ekremturanfirat/Alpina_MainFCC/README.md

# Alpina_MainFCC
Rocket Flight Control Computer 14/02/2025
---
This project is designed based on the specifications of TEKNOFEST 2025 Rocket Competitions A2(Medium Altitude). Please review the license terms of use via the license.txt document.

---
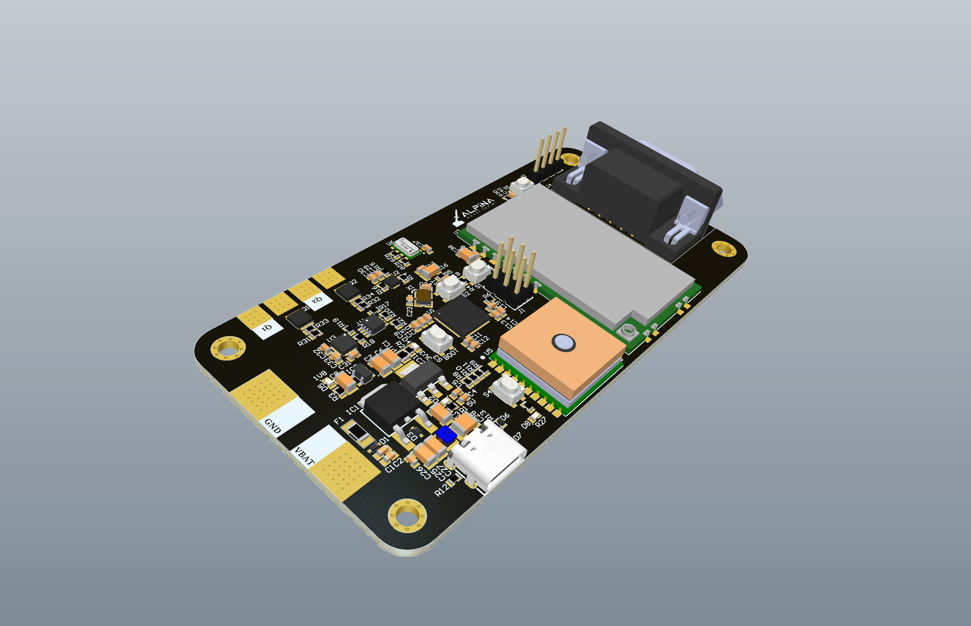
[picture p1: Board/MainFCC_PCBBoardPerspektif.png]


---
## Avionic Design Team Members
I would like to thank _Ayçin Erbil, Ayşe Hazal Demirci, Büşra Yılmaz, Fatmanur Özen and Meryem Şen_, the avionics design members whose leadership I took on in the design of the board throughout the project.

---
### Altium Designer Files
You can download the Altium Designer files of the project from [here](https://github.com/ekremturanfirat/Alpina_MainFCC/tree/main/Altium%20Files).

---
### Schematic Files
You can download the Schematic files of the project from [here](https://github.com/ekremturanfirat/Alpina_MainFCC/tree/main/Schematic).

---
### Board Files
You can download the Board files of the project from [here](https://github.com/ekremturanfirat/Alpina_MainFCC/tree/main/Board).

---
### BOM Files
You can donwload BOM(Bill of Materials) files of the project from [here](https://github.com/ekremturanfirat/Alpina_MainFCC/tree/main/BOM).
