ekremturanfirat/Alpina_MainFCC/Board/MainFCC_PCBBoard.png

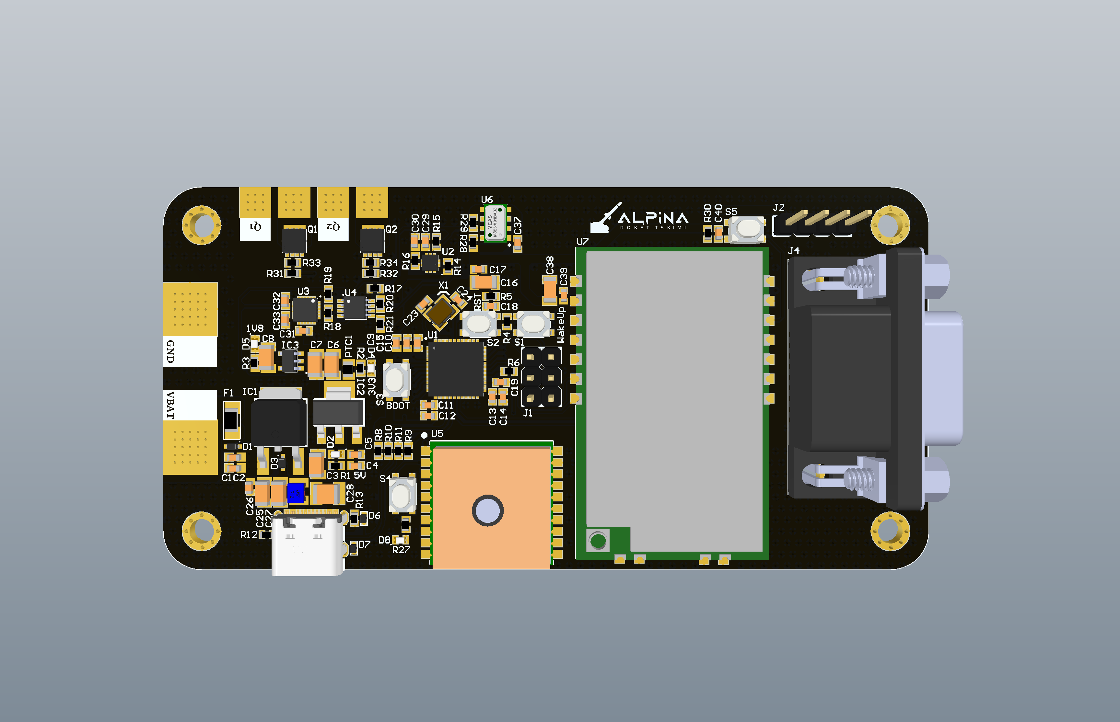
Board/MainFCC_PCBBoard.png
