ekremturanfirat/Alpina_MainFCC/Board/MainFCC_PCBBoardBottom.png

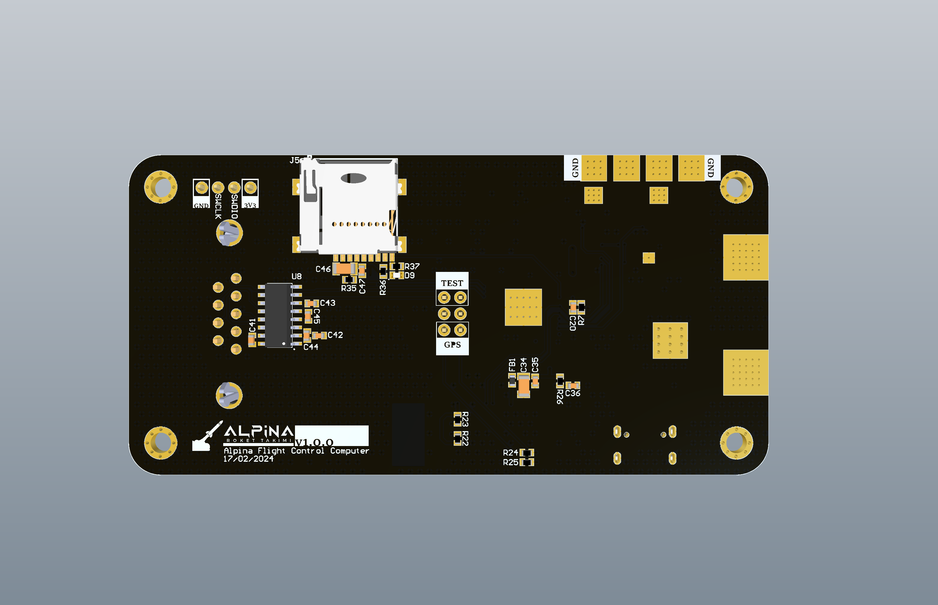
Board/MainFCC_PCBBoardBottom.png
