ekremturanfirat/Alpina_MainFCC/BOM/BOM.pdf

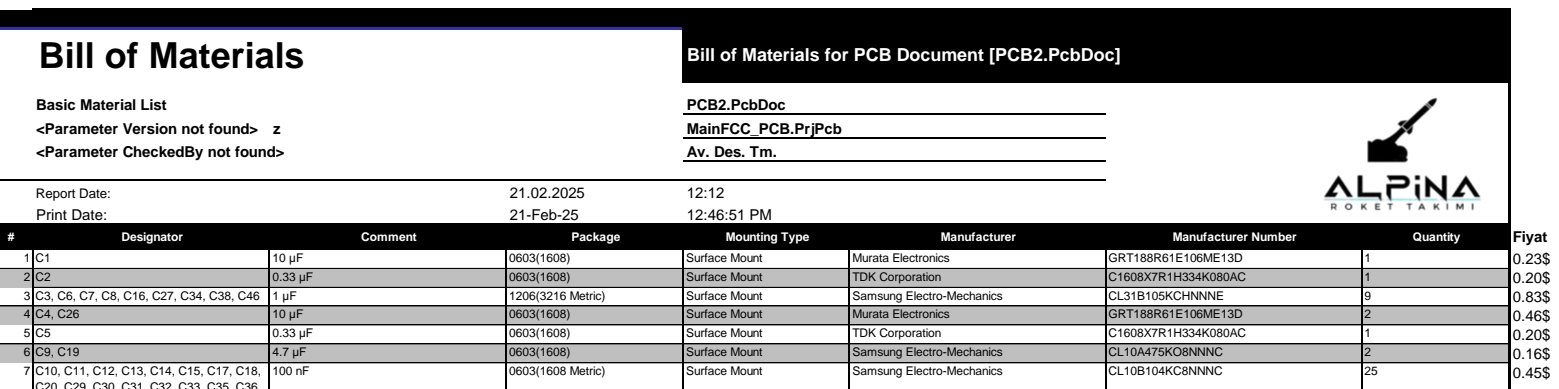
[picture p4: figure]
Basic Material List; PCB2.PcbDoc; Report Date:; Print Date:; 21-Feb-25; Designator; Comment; Package; Mounting Type; Manufacturer; Manufacturer Number; Quantity; Fiyat; Surface Mount; Murata Electronics; GRT188R61E106ME13D; TDK Corporation; Samsung Electro-Mechanics; CL10A475KO8NNNC; 0603(1608 Metric); CL10B104KC8NNNC

Bill of Materials | Bill of Materials for PCB Document [PCB2.PcbDoc]
<Parameter Version not found> z | MainFCC_PCB.PrjPcb
<Parameter CheckedBy not found> | Av. Des. Tm.
3 | C3, C6, C7, C8, C16, C27, C34, C38, C46 | 1 µF | 1206(3216 Metric) | Surface Mount | Samsung Electro-Mechanics | CL31B105KCHNNNE | 9 | 0.83$

C10, C11, C12, C13, C14, C15, C17, C18, C20, C29, C30, C31, C32, C33, C35, C36, C37, C39, C40, C41, C42, C43, C44, C45, C47

8 | C23, C24 | 18 pF | 0603(1608) | Surface Mount | YAGEO | CC0603JRNPO9BN180 | 2 | 0.20$
9 | C25 | 47 µF | 1206(3216) | Surface Mount | TDK Corporation | C3216X5R1E476M160AC | 1 | 0.91$
10 | C28 | 100 µF | 1210(3225 Metric) | Surface Mount | Samsung Electro-Mechanics | CL32A107MPVNNNE | 1 | 1.13$
11 | D1, D3 | B0520LW-7-F | SOD-123 | Surface Mount | Diodes Incorporated | B0520LW-7-F | 2 | 0.36$
12 | D2, D4, D5 | Red | 0603(1608) | Surface Mount | Würth Elektronik | 150060RS75000 | 3 | 0.42$
13 | D6, D7 | DESD3V3S1BL-7B | 0402 (1006 Metric) | Surface Mount | Diodes Incorporated | DESD3V3S1BL-7B | 2 | 0.34$
14 | D8 | Green | 0603(1608) | Surface Mount | Würth Elektronik | 150060GS75000 | 1 | 0.14
15 | D9 | White | 0603(1608) | Surface Mount | Harvatek Corporation | B1931TW--20P000314U1930 | 1 | 0.10$
16 | F1 | C1Q 5 | 1206(3216) | Surface Mount | Bel Fuse Inc. | C1Q 5 | 1 | 0.37$
17 | FB1 | BLM18BD601SN1D | 0603(1608 Metric) | Surface Mount | Murata Electronics | BLM18BD601SN1D | 1 | 0.10$
18 | IC1 | 7805 | DPAK | Surface Mount | onsemi | MC7805BDTG | 1
19 | IC2 | NCP1117 - 3v3 | SOT-223 | Surface Mount | onsemi | NCP1117ST33T3G | 1 | 1.17$
20 | IC3 | MIC5504-1.8YM5-TR | SOT-23-5 | Surface Mount | Microchip Technology | MIC5504-1.8YM5-TR | 1 | 0.16$

21

J1 | 2x3 | | 1
22 | J2 | 1x4 | | 1
23 | J3 | USB4105 | USB4105 | THT - SMD R/A | GCT | USB4105-GF-A | 1 | 0.78$
24 | J4 | Female D-Sub | | THT | Assmann WSW Components | A-DF 09 A/KG-T2S | 1 | 0.83$
25 | J5 | MEM2075 | MEM2075 | Surface Mount | GCT | MEM2075-00-140-01-A | 1 | 1.86$
26 | L1 | 2.2 µH | 1008 (2520 Metric) | Surface Mount | Samsung Electro-Mechanics | CIGT252008LM2R2MNE | 1 | 0.18$
27 | PTC1 | 0ZCK0020FF2G | 0805(2012) | Surface Mount | Bel Fuse Inc. | 0ZCK0020FF2G | 1 | 0.23$
28 | Q1, Q2 | DMN1004UFV-7 | 8-PowerVDFN | Surface Mount | onsemi | DMN1004UFV-7 | 2 | 1.66$
29 | R1, R2, R3, R4, R37 | 330 | 0603(1608) | Surface Mount | Stackpole Electronics Inc | RMCF0603JT330R | 5 | 0.19$
30 | R5 | 40K | 0603(1608) | Surface Mount | YAGEO | RT0603BRD0740KL | 1 | 0.15$

31

R6, R7, R16, R18, R19, R20, R21, R22, R23, R26, R28, R29, R30, R33, R34, R35, R36

10K | 0603(1608) | Surface Mount | Stackpole Electronics Inc | RMCF0603JT10K0 | 17 | 0.32$
32 | R8, R9 | 1.8K | 0603(1608) | Surface Mount | Stackpole Electronics Inc | RMCF0603JT1K80 | 2 | 0.19$
33 | R10, R11 | 22 | 0603(1608) | Surface Mount | TE Connectivity Passive Product | CRGCQ0603J22R | 2 | 0.20$
34 | R12, R13 | 5.1K | 0603(1608) | Surface Mount | Stackpole Electronics Inc | RMCF0603JT5K10 | 2 | 0.19$
35 | R14, R15 | 4.7K | 0603(1608) | Surface Mount | Stackpole Electronics Inc | RMCF0603FT4K70 | 2 | 0.20$
36 | R17 | 200K | 0603(1608) | Surface Mount | Stackpole Electronics Inc | RMCF0603FT200K | 1 | 0.20$
37 | R24, R25, R27 | 470 | 0603(1608) | Surface Mount | Stackpole Electronics Inc | RMCF0603JT470R | 3 | 0.19$
38 | R31, R32 | 1K | 0603(1608) | Surface Mount | Stackpole Electronics Inc | RMCF0603JT1K00 | 2 | 0.19$
39 | S1, S2, S3, S4, S5 | PTS815-SJM | PTS815 | Surface Mount | C&K | PTS815 SJM 250 SMTR LFS | 5 | 1$
40 | U1 | STM32F411CEU6 | UFQFPN-48 | Surface Mount | STMicroelectronics | STM32F411CEU6 | 1 | 5.37$
41 | U2 | BMP390 | 10-WFLGA | Surface Mount | Bosch Sensortec | BMP390 | 1 | 3.15$
42 | U3 | ICM-20948 | 24-QFN | Surface Mount | TDK InvenSense | ICM-20948 | 1 | 7.11$
43 | U4 | PCA9306DCTR | SSOP-8 | Surface Mount | Texas Instruments | PCA9306DCTR | 1 | 0.55$
44 | U5 | CD-PA1616S | CD-PA1616S | Surface Mount | Adafruit | 790 | 1 | 25$
45 | U6 | MS561101BA03-50 | MS561101BA03-50 | Surface Mount | TE Connectivity Measurement Specialties | MS561101BA03-50 | 1 | 9.30$
46 | U7 | Ebyte-E32-868T30s | | | Ebyte | E32-868T30s | 1 | 15.21$
47 | U8 | MAX3232ESE+ | SOIC-16 | Surface Mount | Analog Devices Inc./Maxim Integrated | MAX3232ESE+ | 1 | 10.46$
48 | X1 | 26 MHz | 4-SMD | Surface Mount | TXC CORPORATION | 7M-26.000MAAJ-T | 1 | 0.89$
Approved | Notes | 119 | 93.53$
Altium Limited Confidential | 21.02.2025 | Page 1
