ekremturanfirat/Alpina_MainFCC/BOM/MainFCC_PCB.xlsx

 | Bill of Materials |  |  | Bill of Materials for Project [MainFCC_PCB.PrjPcb]
 | Basic Material List |  |  | MainFCC_PCB.PrjPcb
 | v1.0.0 |  |  | MainFCC_PCB.PrjPcb
 |  |  |  | Av. Des. Tm.
 | Report Date: |  | 9.02.2025 | 15:32
 | Print Date: |  | 2025-02-09 | 15:37:10
# | Designator | Comment | Package | Mounting Type | Manufacturer | Manufacturer Number | Quantity
1 | C1 | 10 µF | 0603(1608) | Surface Mount | Murata Electronics | GRT188R61E106ME13D | 1
2 | C2 | 0.33 µF | 0603(1608) | Surface Mount | TDK Corporation | C1608X7R1H334K080AC | 1
3 | C3 | 1 µF | 1206(3216 Metric) | Surface Mount | Samsung Electro-Mechanics | CL31B105KCHNNNE | 1
4 | C4, C26 | 10 µF | 0603(1608) | Surface Mount | Murata Electronics | GRT188R61E106ME13D | 2
5 | C5 | 0.33 µF | 0603(1608) | Surface Mount | TDK Corporation | C1608X7R1H334K080AC | 1
6 | C6, C7, C8, C16, C27, C34, C38, C46 | 1 µF | 1206(3216 Metric) | Surface Mount | Samsung Electro-Mechanics | CL31B105KCHNNNE | 8
7 | C9, C19 | 4.7 µF | 0603(1608) | Surface Mount | Samsung Electro-Mechanics | CL10A475KO8NNNC | 2
8 | C10, C11, C12, C13, C14, C15, C17, C18, C20, C29, C30, C31, C32, C33, C35, C36, C37, C39, C40, C41, C42, C43, C44, C45, C47 | 100 nF | 0603(1608 Metric) | Surface Mount | Samsung Electro-Mechanics | CL10B104KC8NNNC | 25
9 | C21, C22 | 5 pF | 0603(1608) | Surface Mount | Samsung Electro-Mechanics | CL10C050CB81PNC | 2
10 | C23, C24 | 18 pF | 0603(1608) | Surface Mount | YAGEO | CC0603JRNPO9BN180 | 2
11 | C25 | 47 µF | 1206(3216) | Surface Mount | TDK Corporation | C3216X5R1E476M160AC | 1
12 | C28 | 100 µF | 1210(3225 Metric) | Surface Mount | Samsung Electro-Mechanics | CL32A107MPVNNNE | 1
13 | D1, D3 | B0520LW-7-F | SOD-123 | Surface Mount | Diodes Incorporated | B0520LW-7-F | 2
14 | D2, D4, D5 | Red | 0603(1608) | Surface Mount | Würth Elektronik | 150060RS75000 | 3
15 | D6, D7 | DESD3V3S1BL-7B | 0402 (1006 Metric) | Surface Mount | Diodes Incorporated | DESD3V3S1BL-7B | 2
16 | D8 | Green | 0603(1608) | Surface Mount | Würth Elektronik | 150060GS75000 | 1
17 | D9 | White | 0603(1608) | Surface Mount | Harvatek Corporation | B1931TW--20P000314U1930 | 1
18 | F1 | C1Q 5 | 1206(3216) | Surface Mount | Bel Fuse Inc. | C1Q 5 | 1
19 | FB1 | BLM18BD601SN1D | 0603(1608 Metric) | Surface Mount | Murata Electronics | BLM18BD601SN1D | 1
20 | IC1 | 7805 | DPAK | Surface Mount | onsemi | MC7805BDTG | 1
21 | IC2 | NCP1117 - 3v3 | SOT-223 | Surface Mount | onsemi | NCP1117ST33T3G | 1
22 | IC3 | MIC5504-1.8YM5-TR | SOT-23-5 | Surface Mount | Microchip Technology | MIC5504-1.8YM5-TR | 1
23 | J1 | 2x3 |  |  |  |  | 1
24 | J2 | 1x4 |  |  |  |  | 1
25 | J3 | USB4105 | USB4105 | THT - SMD R/A | GCT | USB4105-GF-A | 1
26 | J4 | Female D-Sub |  | THT | Assmann WSW Components | A-DF 09 A/KG-T2S | 1
27 | J5 | MEM2075 | MEM2075 | Surface Mount | GCT | MEM2075-00-140-01-A | 1
28 | L1 | 2.2 µH | 1008 (2520 Metric) | Surface Mount | Samsung Electro-Mechanics | CIGT252008LM2R2MNE | 1
29 | PTC1 | 0ZCK0020FF2G | 0805(2012) | Surface Mount | Bel Fuse Inc. | 0ZCK0020FF2G | 1
30 | Q1, Q2 | DMN1004UFV-7 | 8-PowerVDFN | Surface Mount | onsemi | DMN1004UFV-7 | 2
31 | R1, R2, R3, R4, R37 | 330 | 0603(1608) | Surface Mount | Stackpole Electronics Inc | RMCF0603JT330R | 5
32 | R5 | 40K | 0603(1608) | Surface Mount | YAGEO | RT0603BRD0740KL | 1
33 | R6, R7, R16, R18, R19, R20, R21, R22, R23, R26, R28, R29, R30, R33, R34, R35, R36 | 10K | 0603(1608) | Surface Mount | Stackpole Electronics Inc | RMCF0603JT10K0 | 17
34 | R8, R9 | 1.8K | 0603(1608) | Surface Mount | Stackpole Electronics Inc | RMCF0603JT1K80 | 2
35 | R10, R11 | 22 | 0603(1608) | Surface Mount | TE Connectivity Passive Product | CRGCQ0603J22R | 2
36 | R12, R13 | 5.1K | 0603(1608) | Surface Mount | Stackpole Electronics Inc | RMCF0603JT5K10 | 2
37 | R14, R15 | 4.7K | 0603(1608) | Surface Mount | Stackpole Electronics Inc | RMCF0603FT4K70 | 2
38 | R17 | 200K | 0603(1608) | Surface Mount | Stackpole Electronics Inc | RMCF0603FT200K | 1
39 | R24, R25, R27 | 470 | 0603(1608) | Surface Mount | Stackpole Electronics Inc | RMCF0603JT470R | 3
40 | R31, R32 | 1K | 0603(1608) | Surface Mount | Stackpole Electronics Inc | RMCF0603JT1K00 | 2
41 | S1, S2, S3, S4, S5 | PTS815-SJM | PTS815 | Surface Mount | C&K | PTS815 SJM 250 SMTR LFS | 5
42 | U1 | STM32F411CEU6 | UFQFPN-48 | Surface Mount | STMicroelectronics | STM32F411CEU6 | 1
43 | U2 | BMP390 | 10-WFLGA | Surface Mount | Bosch Sensortec | BMP390 | 1
44 | U3 | ICM-20948 | 24-QFN | Surface Mount | TDK InvenSense | ICM-20948 | 1
45 | U4 | PCA9306DCTR | SSOP-8 | Surface Mount | Texas Instruments | PCA9306DCTR | 1
46 | U5 | CD-PA1616S | CD-PA1616S | Surface Mount | Adafruit | 790 | 1
47 | U6 | MS561101BA03-50 | MS561101BA03-50 | Surface Mount | TE Connectivity Measurement Specialties | MS561101BA03-50 | 1
48 | U7 | Ebyte-E32-868T30s |  |  | Ebyte | E32-868T30s | 1
49 | U8 | MAX3232ESE+ | SOIC-16 | Surface Mount | Analog Devices Inc./Maxim Integrated | MAX3232ESE+ | 1
50 | X1 | 32.768 kHz | 2-SMD | Surface Mount | ECS Inc. | ECS-.327-5-16-TR | 1
51 | X2 | 26 MHz | 4-SMD | Surface Mount | TXC CORPORATION | 7M-26.000MAAJ-T | 1
Approved |  |  |  | Notes |  |  | 122
