ekremturanfirat/Alpina_MainFCC/Schematic/MainFCC_PCB.pdf

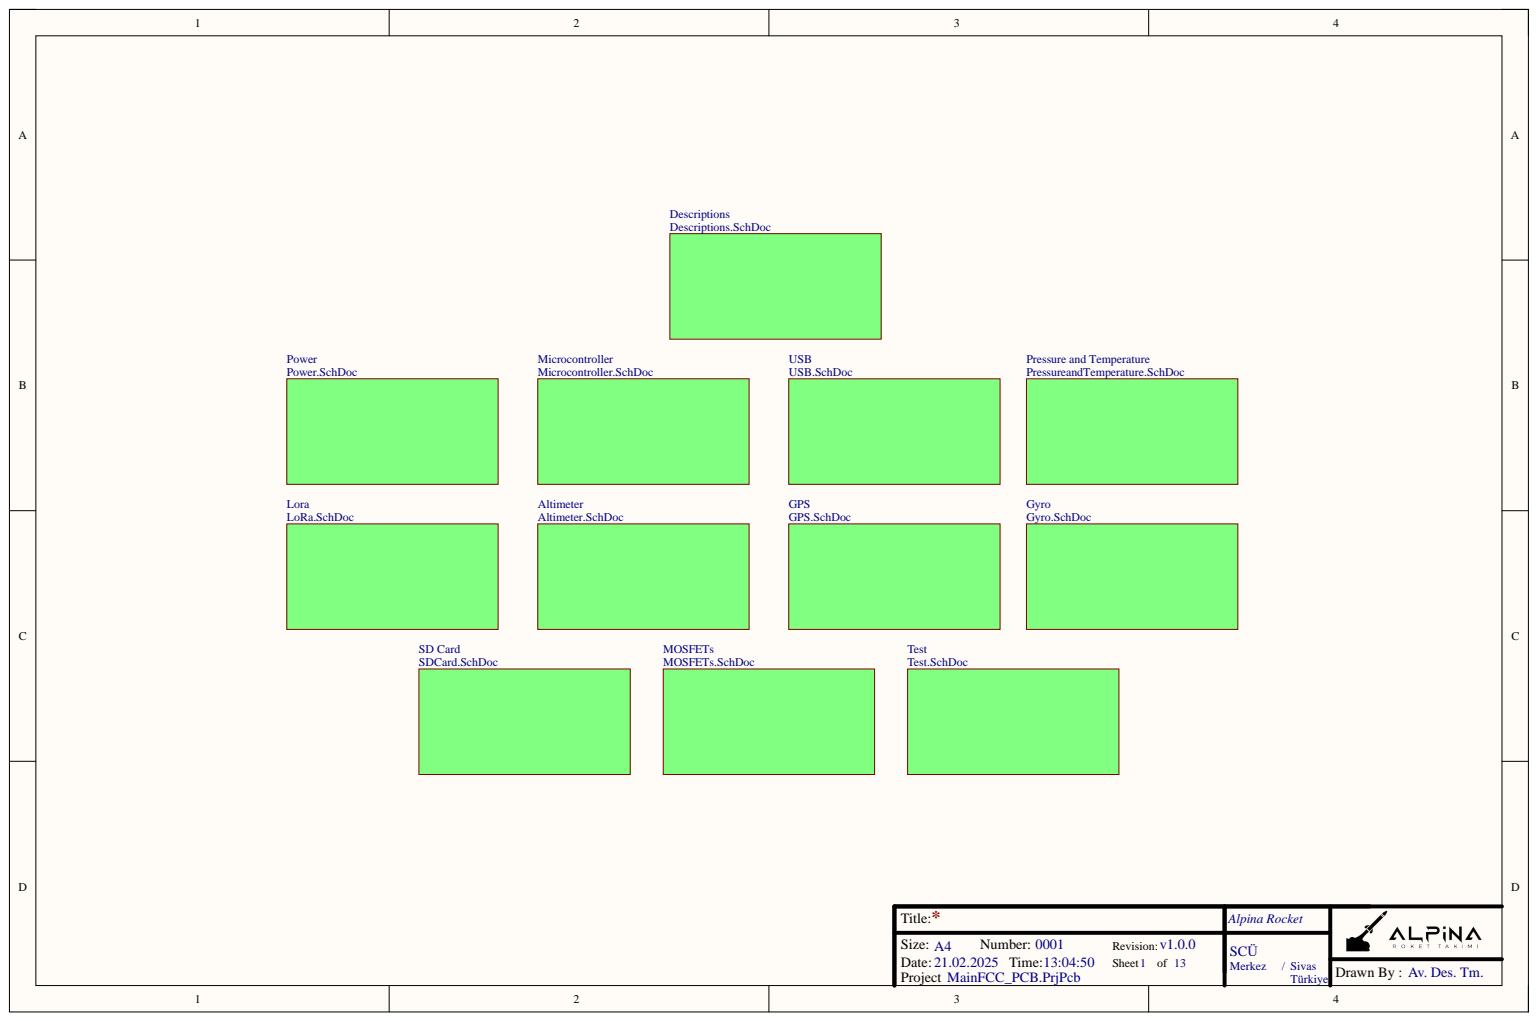
[picture p5: page 1]

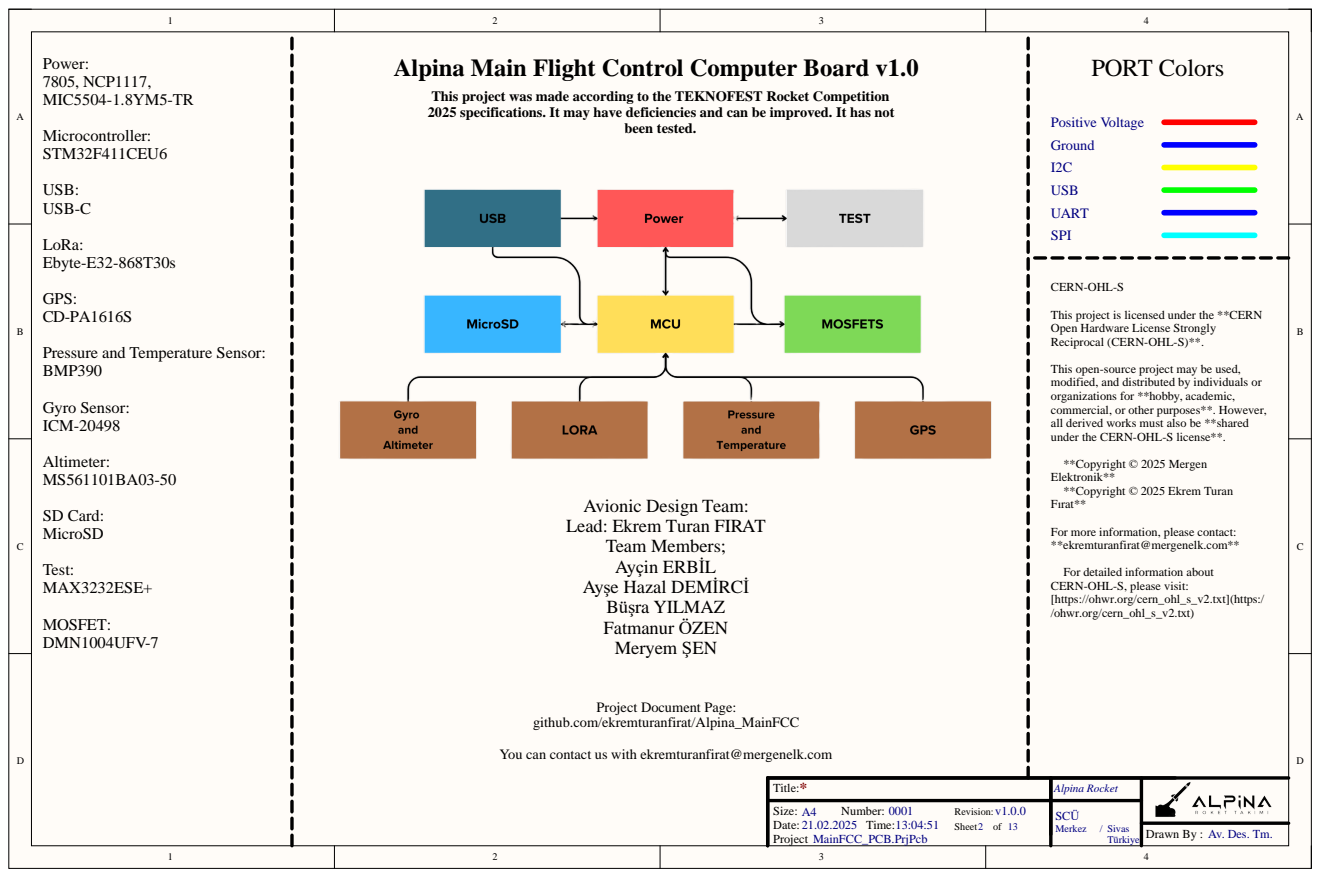
[picture p6: page 2]

Alpina Main Flight Control Computer Board v1.0

This project was made according to the TEKNOFEST Rocket Competition
2025 specifications. It may have deficiencies and can be improved. It has not

This project is licensed under the **CERN
Open Hardware License Strongly
Reciprocal (CERN-OHL-S)**.

This open-source project may be used,
modified, and distributed by individuals or
organizations for **hobby, academic,
commercial, or other purposes**. However,
all derived works must also be **shared
under the CERN-OHL-S license**.

Avionic Design Team:
Lead: Ekrem Turan FIRAT
Team Members;
Ayçin ERBİL
Ayşe Hazal DEMİRCİ
Büşra YILMAZ
Fatmanur ÖZEN
Meryem ŞEN

For more information, please contact:
**ekremturanfirat@mergenelk.com**

For detailed information about
CERN-OHL-S, please visit:
[https://ohwr.org/cern_ohl_s_v2.txt](https:/
/ohwr.org/cern_ohl_s_v2.txt)

You can contact us with ekremturanfirat@mergenelk.com

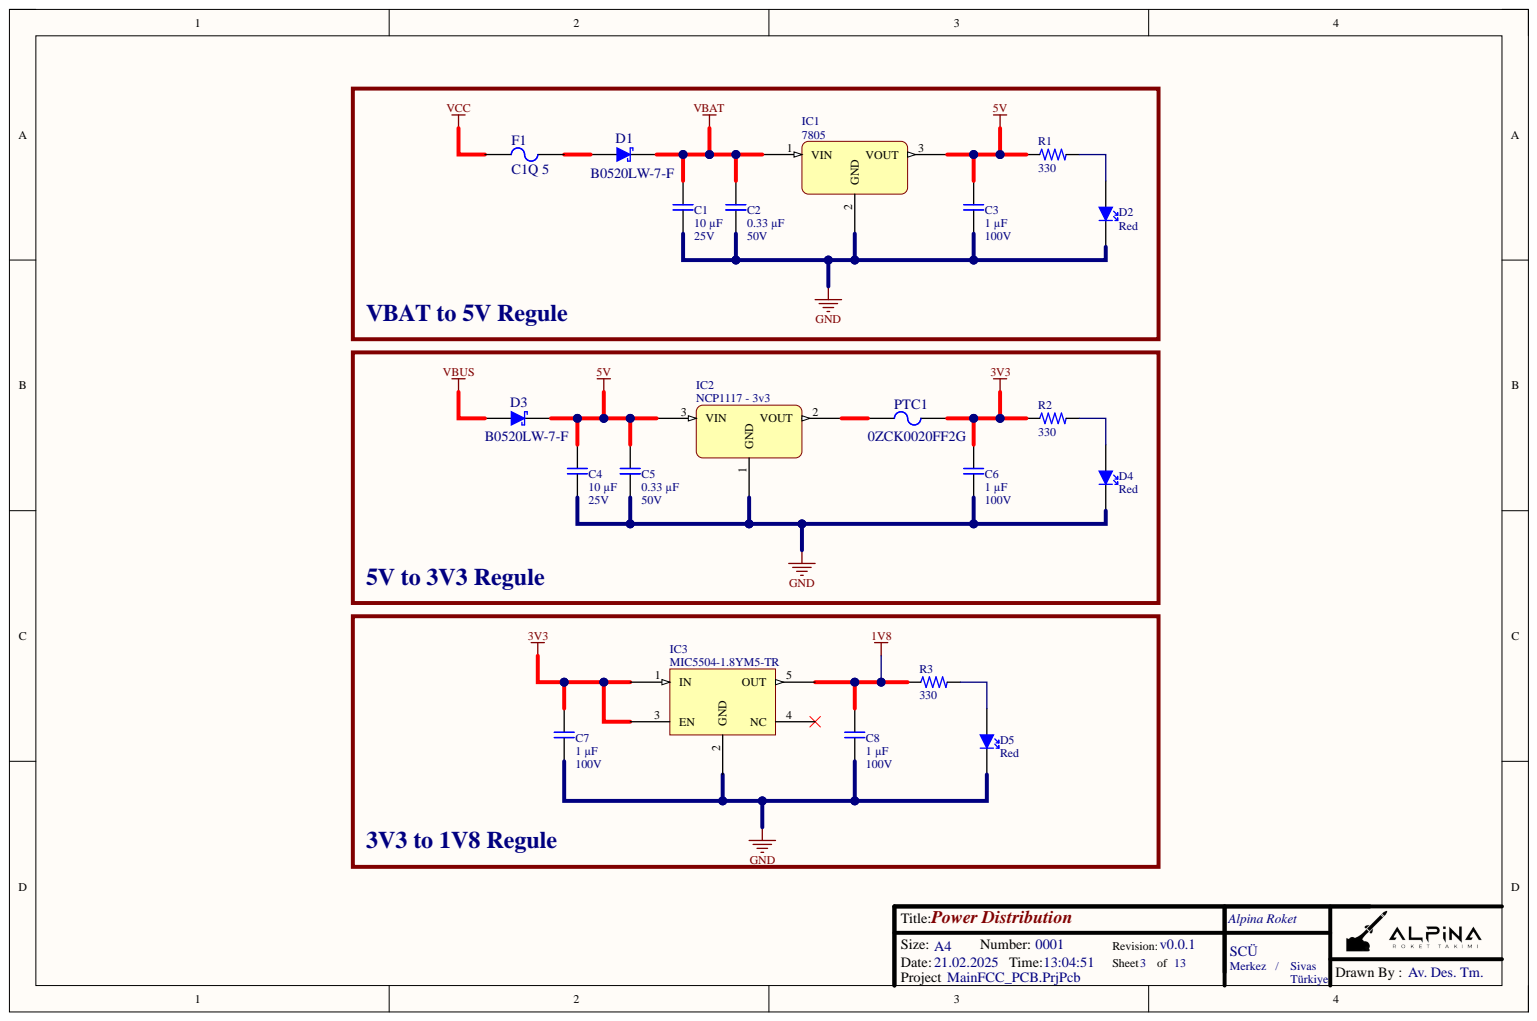
[picture p7: page 3]

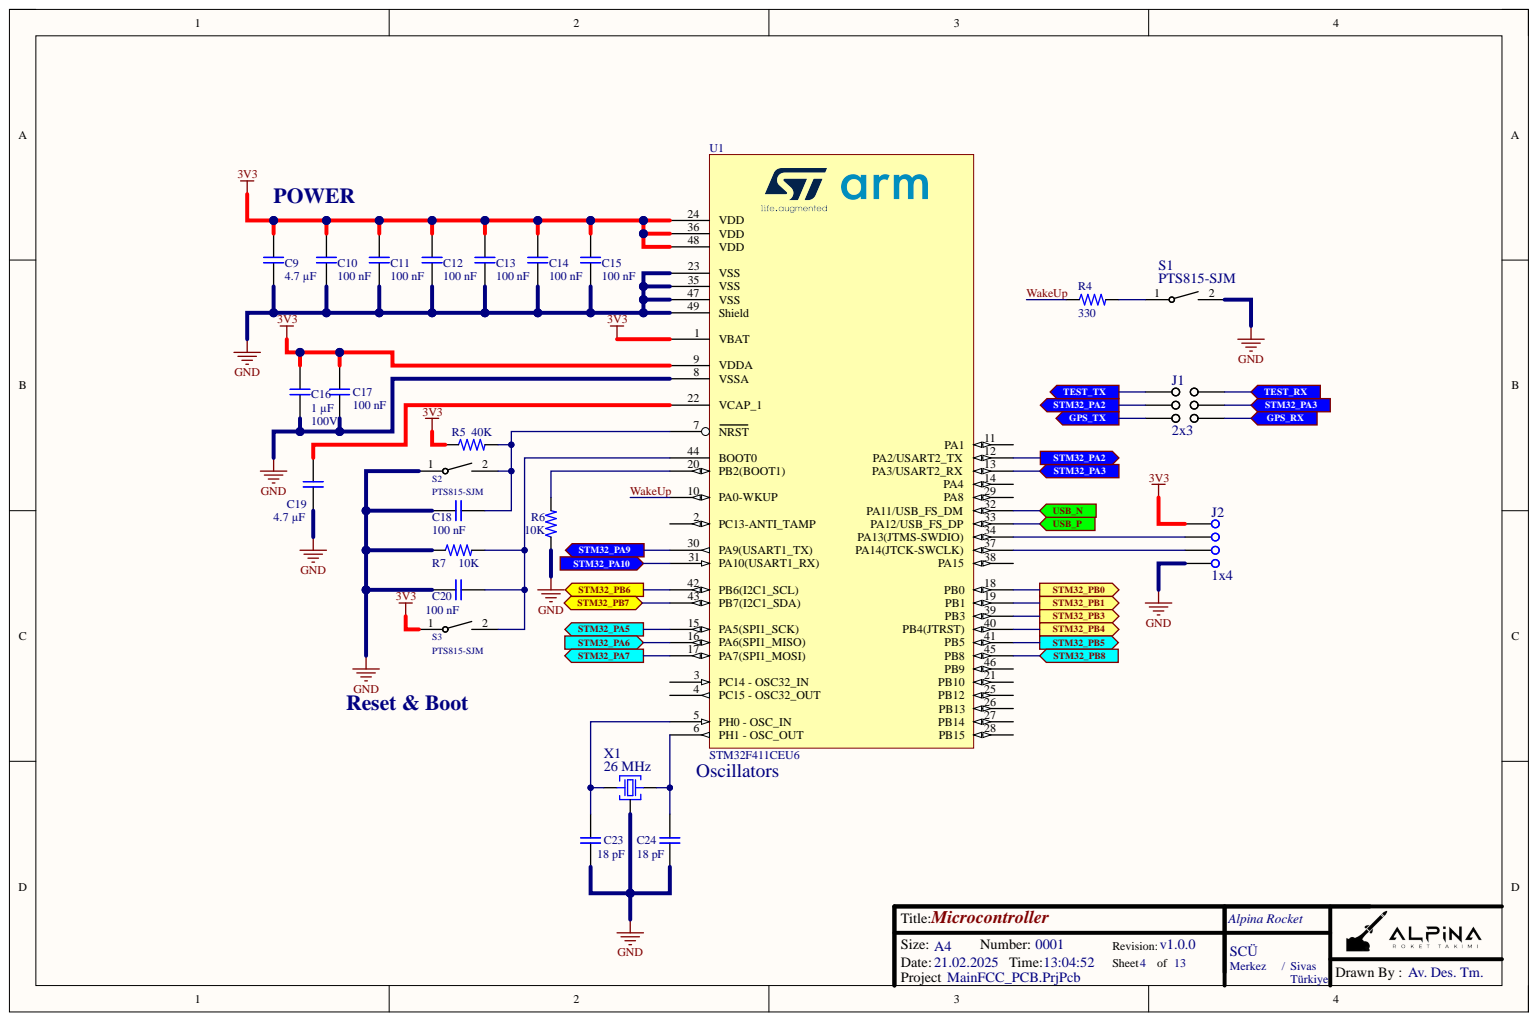
[picture p8: page 4]

VSS 47

3V3 | VBAT 1

1 µF 100V | 3V3 | | NRST 7

BOOT0 44
PB2(BOOT1) 20 PA0-WKUP 10

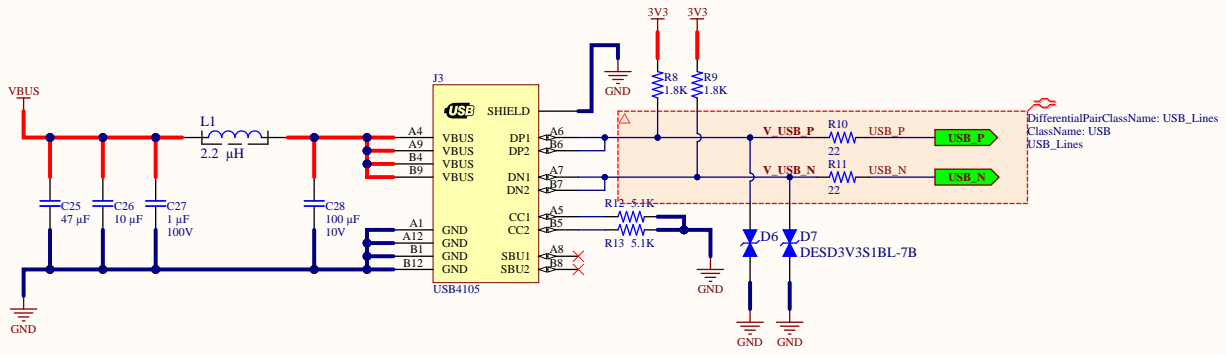
[picture p9: page 5]

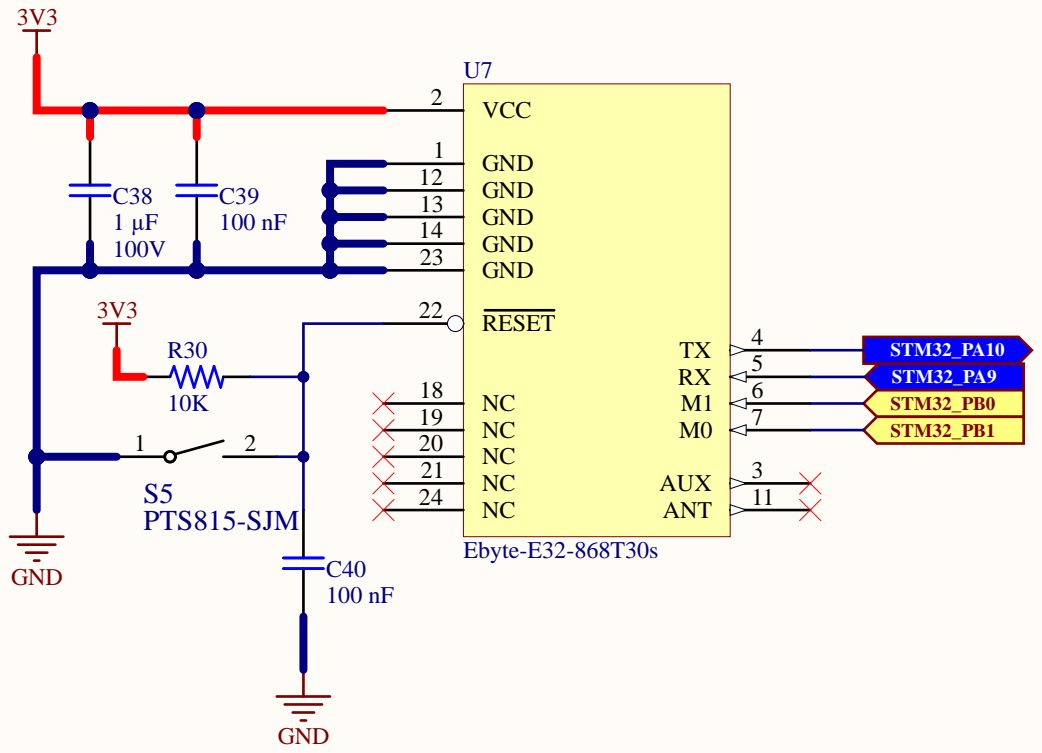
[picture p10: page 6]

100V | | | GND 23

3V3 | RESET 22

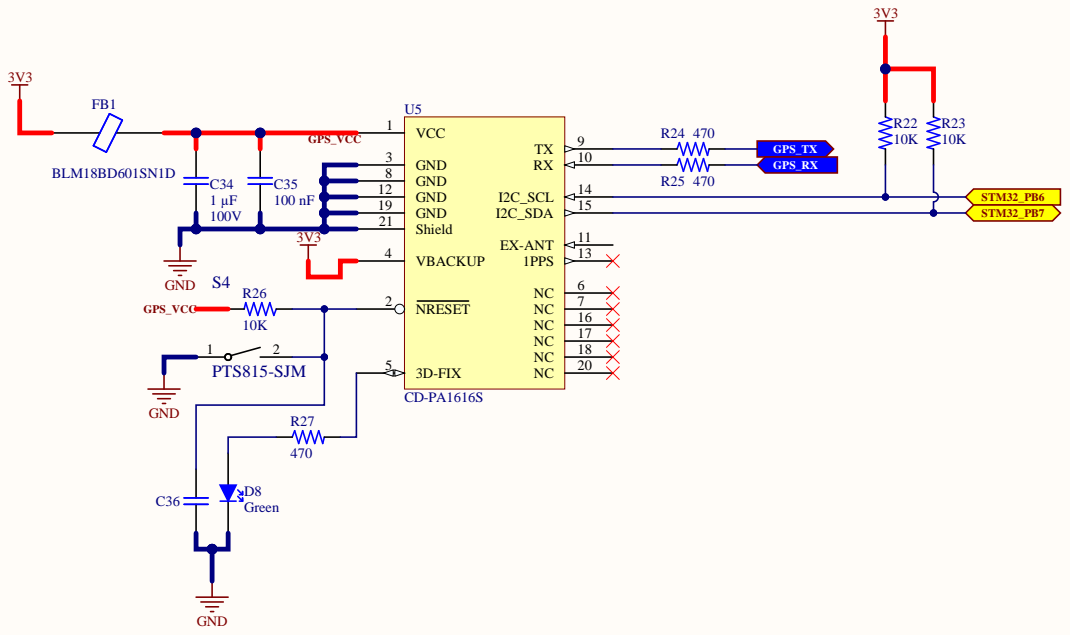
[picture p11: page 7]

100V | | Shield 21

VBACKUP 4

3D-FIX 5

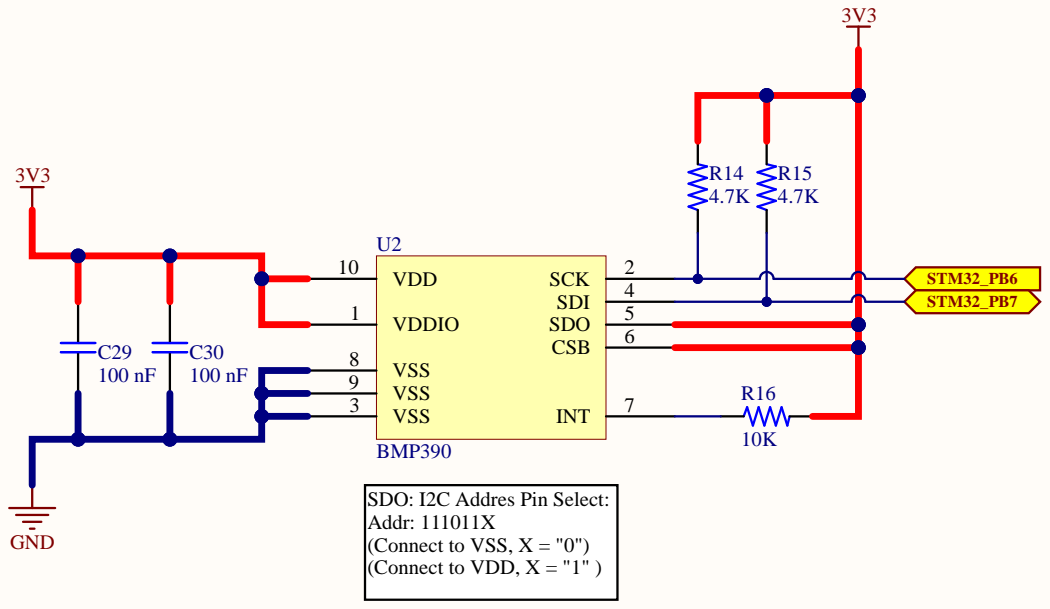
[picture p12: page 8]

SDO: I2C Addres Pin Select:
Addr: 1
(Connect to VSS, X = "0")
(Connect to VDD, X = "1" )

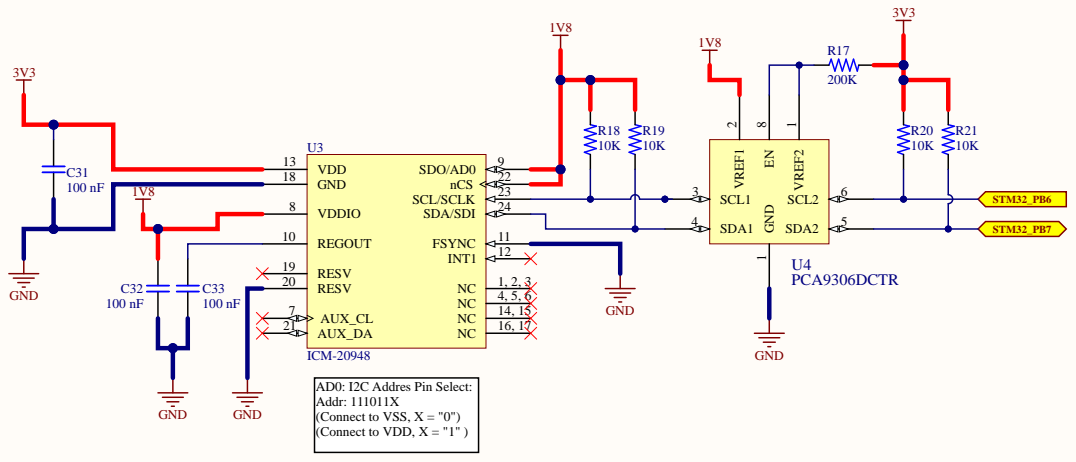
[picture p13: page 9]

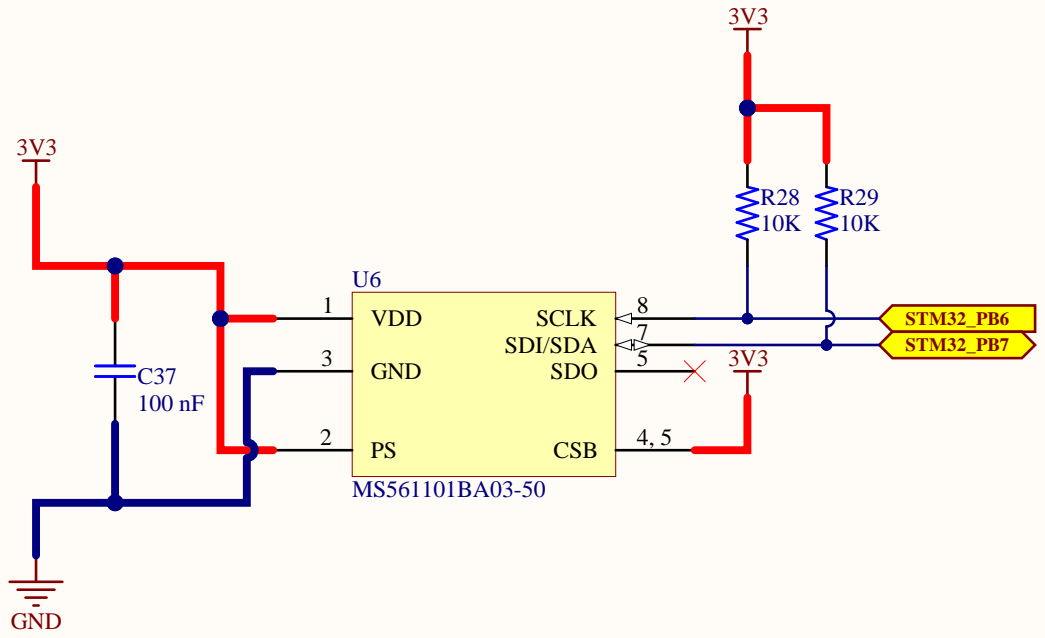
[picture p14: page 10]

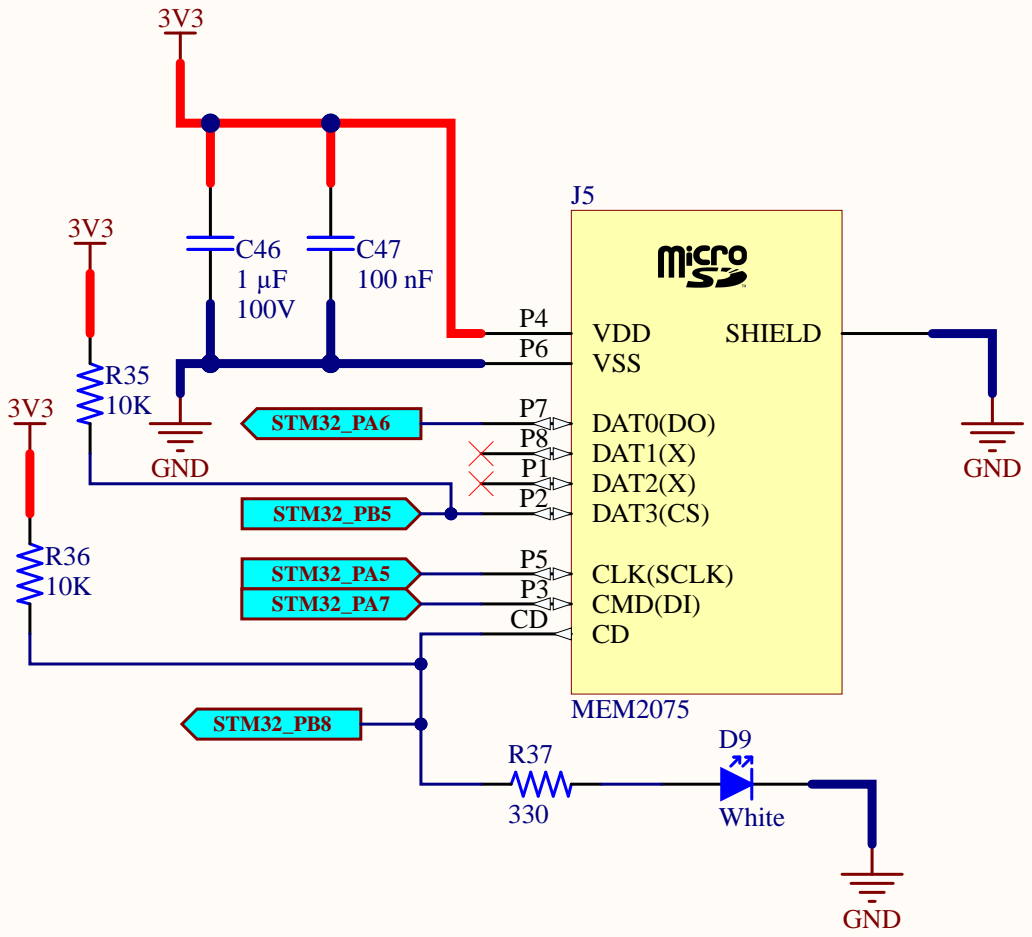
[picture p15: page 11]

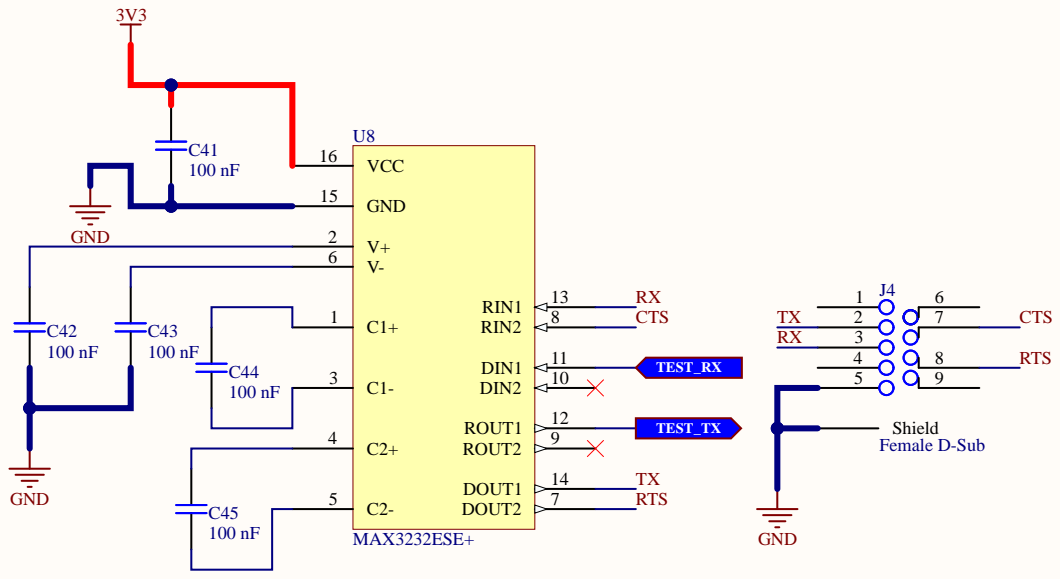
[picture p16: page 12]

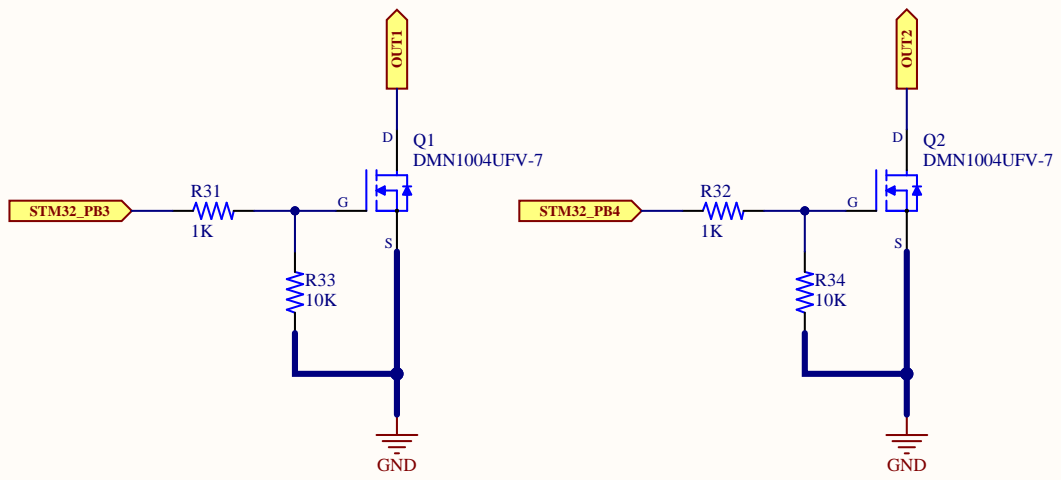
[picture p17: page 13]
