ekremturanfirat/Alpina_MainFCC/Board/Alpina_MainFCC_Diemensions.pdf

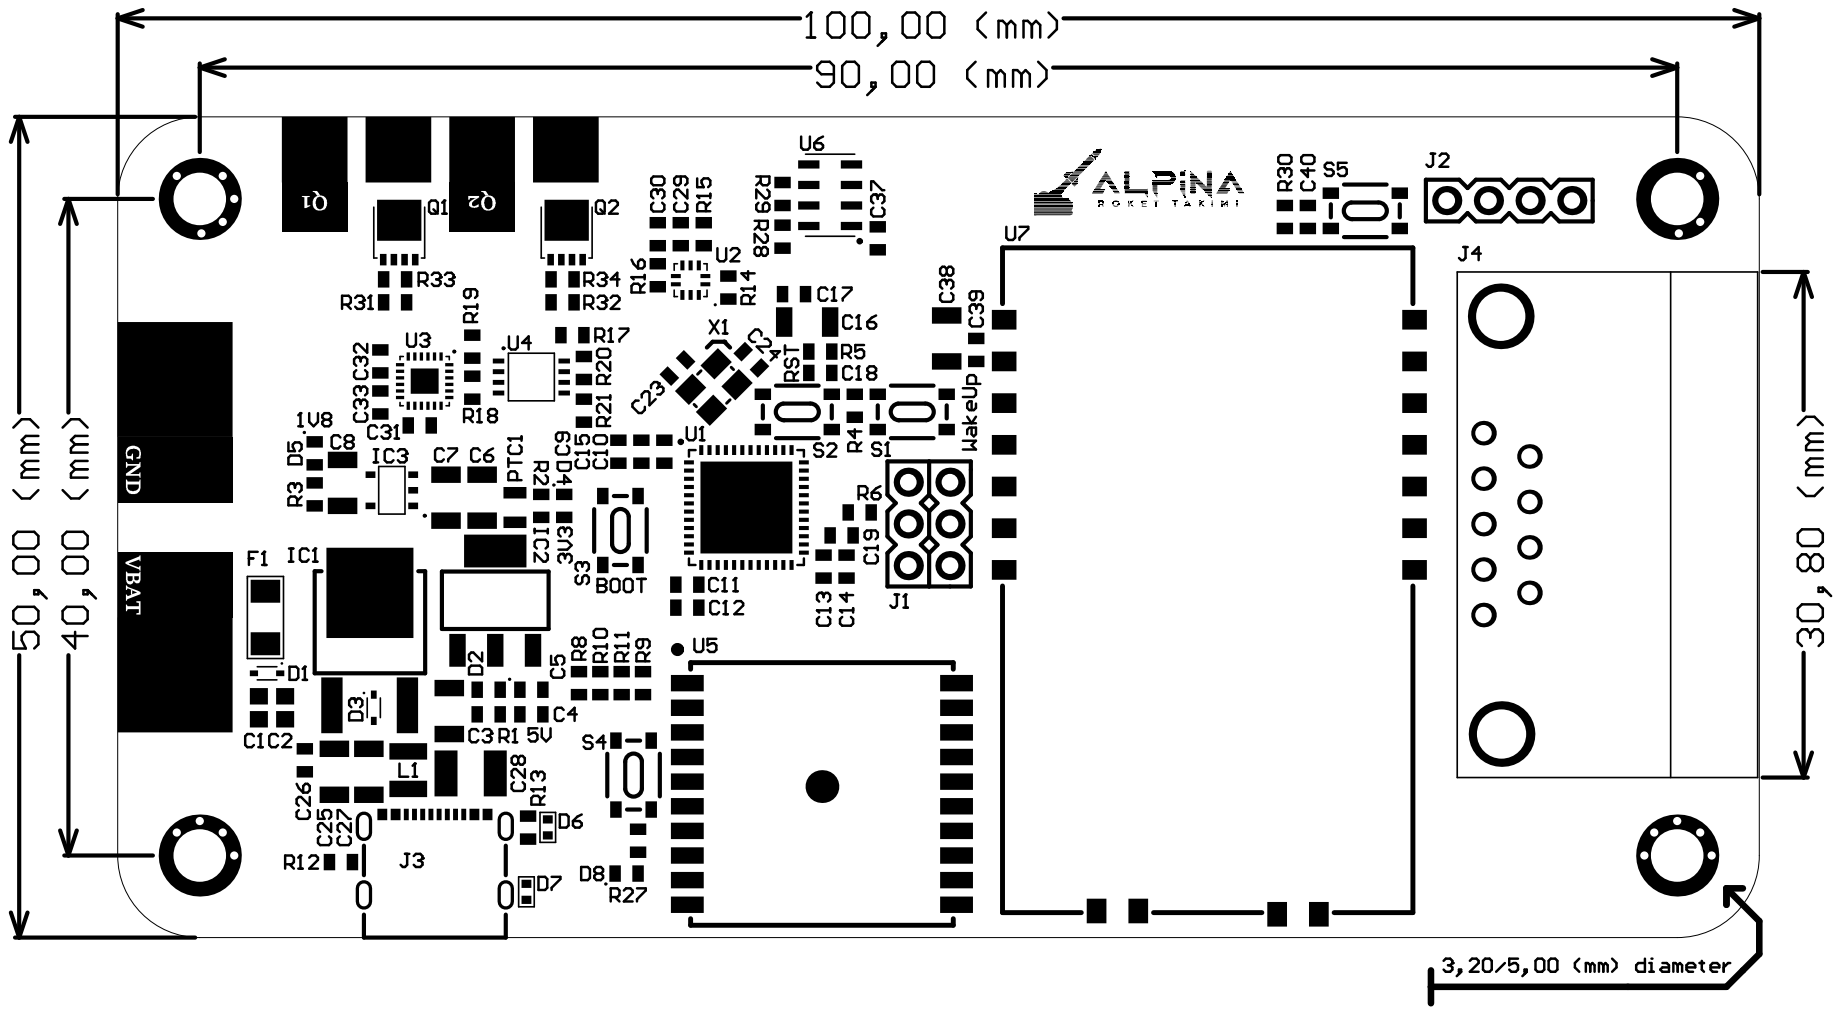
[picture p18: page 1]
