ekremturanfirat/Alpina_MainFCC/(list of files, drawings)

Other design files:
Altium Files/Altimeter.SchDoc
Altium Files/Descriptions.SchDoc
Altium Files/GPS.SchDoc
Altium Files/Gyro.SchDoc
Altium Files/LoRa.SchDoc
Altium Files/Main.SchDoc
Altium Files/MainFCC_PCB.PrjPcb
Altium Files/MainFCC_PCBBoard.PcbDoc
Altium Files/Microcontroller.SchDoc
Altium Files/MOSFETs.SchDoc
Altium Files/Power.SchDoc
Altium Files/Pressure.SchDoc
Altium Files/PressureandTemperature.SchDoc
Altium Files/SDCard.SchDoc
Altium Files/Test.SchDoc
Altium Files/USB.SchDoc
